class-ab/teensy-synth/schematic.pdf

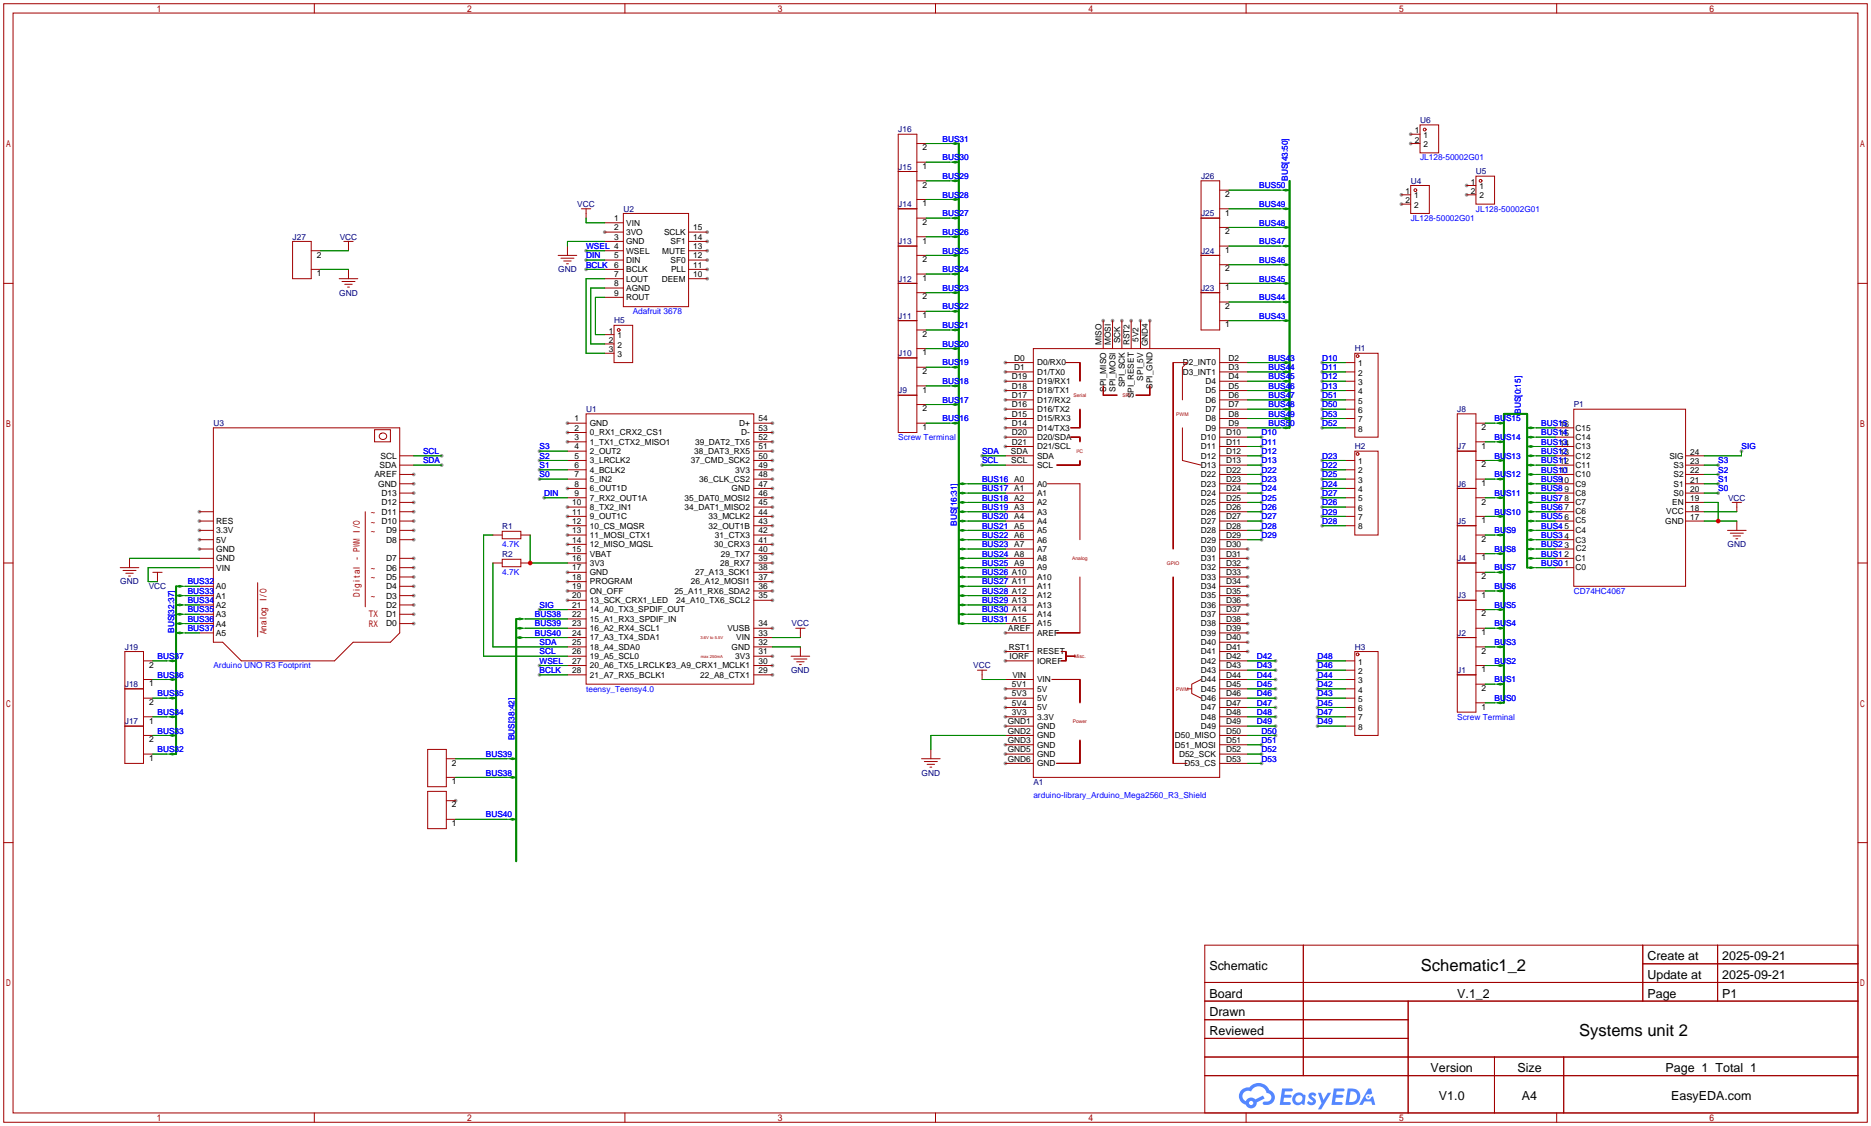
[picture p1: page 1]

DEEM 10 PLL 11 SF0 12 MUTE 13 SF1 14 SCLK 15

Schematic | Schematic1_2 | Create at | 2025-09-21

Update at | 2025-09-21

Board | V.1_2 | Page | P1
Drawn | | Systems unit 2
Reviewed

Version | Size | Page 1 Total 1
V1.0 | A4 | EasyEDA.com
