class-ab/teensy-synth/src/teensy/main.cpp

#include <Arduino.h>
#include <Wire.h>
#include <Audio.h>
// =====================================================
// Teensy 3-VCO Synth + MUX + I2C System (MASTER)
// 6 voices × 3 VCOs = 18 waveform generators
// Per-voice VCF and VCA
// =====================================================
#define MEGA_ADDRESS 0x08
#define UNO_ADDRESS 0x09
const uint8_t I2C_PACKETS_PER_FRAME = 4;
const uint8_t I2C_PACKET_SIZE = 3;
const uint8_t I2C_FRAME_SIZE = I2C_PACKETS_PER_FRAME * I2C_PACKET_SIZE;

// =====================================================
// POTENTIOMETER SCALING CONFIGURATION
// =====================================================
// Define which inputs use LINEAR or LOGARITHMIC scaling
// LINEAR: Direct value mapping (default)
// LOGARITHMIC: Exponential curve for more natural control
// 
// Usage: Set to true for LOGARITHMIC, false for LINEAR
// =====================================================

struct PotScaling {
  const char* name;
  bool isLogarithmic;
};

// MUX Pot Scaling (MUX_0 through MUX_9)
// MUX Pot Scaling (MUX_0 through MUX_9)
PotScaling muxPotScaling[10] = {
  {"MUX_0", false},   // VCO1 Detune - LINEAR
  {"MUX_1", false},   // VCO2 Detune - LINEAR
  {"MUX_2", false},   // VCO3 Detune - LINEAR
  {"MUX_3", true},    // Master Volume - LOGARITHMIC
  {"MUX_4", false},   // VCO2 Volume - LINEAR
  {"MUX_5", false},   // VCO3 Volume - LINEAR
  {"MUX_6", false},    // VCF Cutoff - LINEAR
  {"MUX_7", true},   // VCF Attack - LOGARITHMIC
  {"MUX_8", true},   // VCF Sustain - LOGARITHMIC
  {"MUX_9", true}    // VCF Resonance - LOGARITHMIC
};

// MEGA Pot Scaling (MEGA_0 through MEGA_15)
PotScaling megaPotScaling[16] = {
  {"MEGA_0", true},   // VCF Decay - LOGARITHMIC
  {"MEGA_1", false},  // VCF Env Amount - LINEAR
  {"MEGA_2", false},  // LFO 1 Speed - LINEAR
  {"MEGA_3", false},  // LFO 2 Speed - LINEAR
  {"MEGA_4", true},   // VCA Attack - LOGARITHMIC
  {"MEGA_5", true},   // VCA Decay - LOGARITHMIC
  {"MEGA_6", false},  // LFO 1 Volume - LINEAR
  {"MEGA_7", false},  // LFO 2 Volume - LINEAR
  {"MEGA_8", true},   // VCA Sustain - LOGARITHMIC
  {"MEGA_9", false},  // LFO 1 Waveform - LINEAR
  {"MEGA_10", false}, // LFO 2 Waveform - LINEAR
  {"MEGA_11", true},  // VCA Release - LOGARITHMIC
  {"MEGA_12", false},  // Reverb Time - LINEAR
  {"MEGA_13", false},  // Reverb Mix - LINEAR
  {"MEGA_14", false},  // Glissando - LINEAR
  {"MEGA_15", false}   // (unused)
};

PotScaling unoPotScaling[4] = {
  {"UNO_0", false},
  {"UNO_1", false},
  {"UNO_2", false},
  {"UNO_3", false}
};

// =====================================================
// SCALING FUNCTIONS
// =====================================================
// Convert raw pot value (0-1023) based on scaling type
int applyPotScaling(int rawValue, bool isLogarithmic) {
  if (!isLogarithmic) {
    return rawValue;  // Linear - return as-is
  }
  
  // Logarithmic scaling using exponential curve
  // This creates a more natural feel for controls like filter cutoff
  float normalized = rawValue / 1023.0;
  float scaled = (exp(normalized * 4.6052) - 1.0) / 99.0;  // exp(4.6052) ≈ 100
  return (int)(scaled * 1023.0);
}

// Reverse function - convert from logarithmic to linear if needed
int reversePotScaling(int scaledValue, bool isLogarithmic) {
  if (!isLogarithmic) {
    return scaledValue;  // Linear - return as-is
  }
  
  // Reverse the logarithmic scaling
  float scaled = scaledValue / 1023.0;
  float normalized = log(scaled * 99.0 + 1.0) / 4.6052;
  return (int)(normalized * 1023.0);
}

// =====================================================
// VCO CONTROL MAPPING - EDIT HERE
// =====================================================
// VCO 1 Controls
#define VCO1_WAVEFORM "MUX_10"
#define VCO1_DETUNE   "MUX_0"
#define VCO1_OCTAVE   "MUX_13"
// VCO 2 Controls
#define VCO2_WAVEFORM "MUX_11"
#define VCO2_VOLUME   "MUX_4"
#define VCO2_DETUNE   "MUX_1"
#define VCO2_OCTAVE   "MUX_14"
// VCO 3 Controls
#define VCO3_WAVEFORM "MUX_12"
#define VCO3_VOLUME   "MUX_5"
#define VCO3_DETUNE   "MUX_2"
#define VCO3_OCTAVE   "MUX_15"
// Master Volume Control
#define MASTER_VOLUME "MUX_3"
// VCF (Filter) Controls
#define VCF_CUTOFF     "MUX_6"
#define VCF_RESONANCE  "MUX_9"
#define VCF_ENV_AMOUNT "MEGA_1"
#define VCF_ATTACK     "MUX_7"
#define VCF_DECAY      "MEGA_0"
#define VCF_SUSTAIN    "MUX_8"
// VCA (Amplifier) Controls
#define VCA_ATTACK     "MEGA_4"
#define VCA_DECAY      "MEGA_5"
#define VCA_SUSTAIN    "MEGA_8"
#define VCA_RELEASE    "MEGA_11"
// Reverb Controls
#define REVERB_TIME     "MEGA_12"
#define REVERB_MIX      "MEGA_13"
#define GLISSANDO       "MEGA_14"
// LFO 1 Controls
#define LFO1_VOLUME   "MEGA_6"
#define LFO1_LOCATION "UNO_LOCATION_0"
#define LFO1_PITCH    "MEGA_2"
#define LFO1_WAVEFORM "MEGA_9"
// LFO 2 Controls
#define LFO2_VOLUME   "MEGA_7"
#define LFO2_LOCATION "UNO_LOCATION_1"
#define LFO2_PITCH    "MEGA_3"
#define LFO2_WAVEFORM "MEGA_10"

enum LFO1Location {
  LFO1_VCO_PITCH = 1,
  LFO1_VCF_CUTOFF,
  LFO1_VCA_VOLUME,
  LFO1_OFF
};

enum LFO2Location {
  LFO2_LFO1_SPEED = 1,
  LFO2_LFO1_VOLUME,
  LFO2_VCF_RESONANCE,
  LFO2_OFF
};

// =====================================================
// MUX Configuration
// =====================================================
const int S0 = 5, S1 = 4, S2 = 3, S3 = 2, SIG_PIN = 14;
const int firstSwitchChannel = 10;
const int numSwitches = 6;
const int totalPositions = 4;
const int switchTolerance = 5;
const int ignoreThreshold = 5;
const int firstPotChannel = 0;
const int numPots = 10;
const int potTolerance = 2;
const int detuneAmt = 1;

int currentPos[numSwitches] = {0};
int lastPotValues[numPots] = {0};

int positions[numSwitches][totalPositions] = {
  {613, 662, 746, 808},
  {411, 464, 558, 643},
  {506, 564, 659, 732},
  {516, 566, 660, 733},
  {462, 513, 610, 690},
  {646, 697, 776, 834}
};

// Enter the measured Uno A0/A1 switch readings here; -1 disables a position.
int unoLocationPositions[2][4] = {
  {804, 867, 965, 1023}, // A0: VCO pitch, VCF cutoff, VCA volume, off
  {804, 867, 965, 1023}  // A1: LFO 1 speed, LFO 1 volume, VCF resonance, off
};
const int unoLocationTolerance = 5;
int unoLocationCurrentPos[2] = {LFO1_OFF, LFO2_OFF};
int unoLocationRawValues[2] = {0, 0};

// Storage for MEGA pot values
int megaPotValues[16] = {0};
int unoPotValues[4] = {0};

// =====================================================
// Audio System
// =====================================================
AudioSynthWaveform waveform[18];
AudioMixer4 vcoMixer[6];
AudioFilterStateVariable filter[6];
AudioEffectEnvelope ampEnv[6];
AudioMixer4 voiceMixer1, voiceMixer2;
AudioMixer4 preEffectsMix;
AudioEffectReverb reverb1;
AudioMixer4 reverbMixer;
AudioMixer4 finalMix;
AudioOutputI2S i2s1;
const float VOICE_MIX_BASE_GAIN = 0.25f;

// Audio connections (same as original)
AudioConnection patchCord1(waveform[0], 0, vcoMixer[0], 0);
AudioConnection patchCord2(waveform[1], 0, vcoMixer[0], 1);
AudioConnection patchCord3(waveform[2], 0, vcoMixer[0], 2);
AudioConnection patchCord4(waveform[3], 0, vcoMixer[1], 0);
AudioConnection patchCord5(waveform[4], 0, vcoMixer[1], 1);
AudioConnection patchCord6(waveform[5], 0, vcoMixer[1], 2);
AudioConnection patchCord7(waveform[6], 0, vcoMixer[2], 0);
AudioConnection patchCord8(waveform[7], 0, vcoMixer[2], 1);
AudioConnection patchCord9(waveform[8], 0, vcoMixer[2], 2);
AudioConnection patchCord10(waveform[9], 0, vcoMixer[3], 0);
AudioConnection patchCord11(waveform[10], 0, vcoMixer[3], 1);
AudioConnection patchCord12(waveform[11], 0, vcoMixer[3], 2);
AudioConnection patchCord13(waveform[12], 0, vcoMixer[4], 0);
AudioConnection patchCord14(waveform[13], 0, vcoMixer[4], 1);
AudioConnection patchCord15(waveform[14], 0, vcoMixer[4], 2);
AudioConnection patchCord16(waveform[15], 0, vcoMixer[5], 0);
AudioConnection patchCord17(waveform[16], 0, vcoMixer[5], 1);
AudioConnection patchCord18(waveform[17], 0, vcoMixer[5], 2);
AudioConnection patchCord19(vcoMixer[0], 0, filter[0], 0);
AudioConnection patchCord20(vcoMixer[1], 0, filter[1], 0);
AudioConnection patchCord21(vcoMixer[2], 0, filter[2], 0);
AudioConnection patchCord22(vcoMixer[3], 0, filter[3], 0);
AudioConnection patchCord23(vcoMixer[4], 0, filter[4], 0);
AudioConnection patchCord24(vcoMixer[5], 0, filter[5], 0);
AudioConnection patchCord31(filter[0], 0, ampEnv[0], 0);
AudioConnection patchCord32(filter[1], 0, ampEnv[1], 0);
AudioConnection patchCord33(filter[2], 0, ampEnv[2], 0);
AudioConnection patchCord34(filter[3], 0, ampEnv[3], 0);
AudioConnection patchCord35(filter[4], 0, ampEnv[4], 0);
AudioConnection patchCord36(filter[5], 0, ampEnv[5], 0);
AudioConnection patchCord37(ampEnv[0], 0, voiceMixer1, 0);
AudioConnection patchCord38(ampEnv[1], 0, voiceMixer1, 1);
AudioConnection patchCord39(ampEnv[2], 0, voiceMixer1, 2);
AudioConnection patchCord40(ampEnv[3], 0, voiceMixer1, 3);
AudioConnection patchCord41(ampEnv[4], 0, voiceMixer2, 0);
AudioConnection patchCord42(ampEnv[5], 0, voiceMixer2, 1);
AudioConnection patchCord43(voiceMixer1, 0, preEffectsMix, 0);
AudioConnection patchCord44(voiceMixer2, 0, preEffectsMix, 1);
AudioConnection patchCord48(preEffectsMix, 0, reverb1, 0);
AudioConnection patchCord49(preEffectsMix, 0, reverbMixer, 0);
AudioConnection patchCord50(reverb1, 0, reverbMixer, 1);
AudioConnection patchCord51(reverbMixer, 0, finalMix, 0);
AudioConnection patchCord52(reverbMixer, 0, finalMix, 1);
AudioConnection patchCord53(finalMix, 0, i2s1, 0);

// =====================================================
// VCO State Variables
// =====================================================
struct VCOSettings {
  int waveform;
  float volume;
  float detune;
  int octave;
};

VCOSettings vco[3] = {
  {WAVEFORM_SINE, 1.0, 0.0, 3},    // VCO1 - volume always 1.0 (controlled by master)
  {WAVEFORM_SINE, 0.33, 0.0, 3},   // VCO2
  {WAVEFORM_SINE, 0.33, 0.0, 3}    // VCO3
};

float masterVolume = 0.5;  // Master volume control

struct FilterSettings {
  float cutoff;
  float resonance;
  float envAmount;
  float attack;
  float decay;
  float sustain;
};

FilterSettings vcfSettings = {1000.0, 0.7, 0.0, 10.0, 100.0, 0.5};

struct FilterEnvState {
  bool active;
  unsigned long noteOnTime;
};

FilterEnvState filterEnvState[6];

struct AmplifierSettings {
  float attack;
  float decay;
  float sustain;
  float release;
};

AmplifierSettings vcaSettings = {10.0, 100.0, 0.8, 200.0};

struct ReverbSettings {
  float time;
  float mix;
};

ReverbSettings reverbSettings = {2.55, 0.3};

float activeFreq[6] = {0.0};
float currentFreq[6] = {0.0};
float glideStartFreq[6] = {0.0};
unsigned long glideStartTimeMicros[6] = {0};
unsigned long glideDurationMicros[6] = {0};
float lastPlayedFrequency = 0.0f;
float lfo1Phase = 0.0f;
float lfo2Phase = 0.0f;
float lfo1Output = 0.0f;
float lfo2Output = 0.0f;
float lfo1PitchOffsetSemitones = 0.0f;
float lfo1VcaGainMultiplier = 1.0f;
float lastAppliedFilterResonance = -1.0f;

// =====================================================
// Timing
// =====================================================
unsigned long lastMuxTime = 0;
const unsigned long MUX_INTERVAL = 50;
unsigned long lastFilterUpdateMicros = 0;
const unsigned long FILTER_UPDATE_INTERVAL_MICROS = 250;
unsigned long lastI2CPoll = 0;
const unsigned long I2C_POLL_INTERVAL = 5;
unsigned long lastLfoUpdateMicros = 0;
unsigned long lastGlissandoUpdateMicros = 0;
const float LFO_MIN_SPEED_HZ = 0.2f;
const float LFO_MAX_SPEED_HZ = 400.0f;
const float GLISSANDO_MAX_TIME_SECONDS = 2.0f;
const unsigned long GLISSANDO_UPDATE_INTERVAL_MICROS = 1000;
const float LFO1_PITCH_RANGE_SEMITONES = 5.0f;
const float LFO1_CUTOFF_RANGE_OCTAVES = 4.0f;
const float LFO2_SPEED_RANGE_OCTAVES = 2.0f;
const float LFO2_RESONANCE_RANGE = 4.3f;

void pollControllers();
void pollController(uint8_t address);
void updateFilterEnvelopes();
void updateLFOs();
void readMuxSwitch(int channel, int switchIndex);
void readMuxPot(int channel, int potIndex);
void readUnoLocationSwitch(uint8_t switchIndex, int rawValue);
void updateVCOParameters();
void updateVCFParameters();
void updateVCAParameters();
void updateReverbParameters();
void updateMasterVolume();
int getControlValue(const char* control, bool isSwitch);
int mapWaveform(int position);
int mapPotToFourPosition(int value);
float calculateLfoWaveform(float phase, int position);
float calculateVcoFrequency(int voice, int vcoIndex);
void updateGlissando();
void updateActiveVoiceFrequencies();
void updateActiveVoices();
void handleNoteEvent(byte cmd, byte note);

// =====================================================
// Setup
// =====================================================
void setup() {
  Serial.begin(115200);
  delay(500);
  Serial.println("Teensy 3-VCO Synth (I2C MASTER) - ±5 Semitone Detune + Master Volume");

  pinMode(S0, OUTPUT);
  pinMode(S1, OUTPUT);
  pinMode(S2, OUTPUT);
  pinMode(S3, OUTPUT);

  AudioMemory(180);

  // Initialize waveforms
  for (int i = 0; i < 18; i++) {
    waveform[i].begin(WAVEFORM_SINE);
    waveform[i].amplitude(1.0);
  }

  // Initialize mixers with VCO volumes
  for (int i = 0; i < 6; i++) {
    vcoMixer[i].gain(0, vco[0].volume);
    vcoMixer[i].gain(1, vco[1].volume);
    vcoMixer[i].gain(2, vco[2].volume);
    vcoMixer[i].gain(3, 0.0);
  }

  // Initialize filters and envelopes
  for (int i = 0; i < 6; i++) {
    filter[i].frequency(vcfSettings.cutoff);
    filter[i].resonance(vcfSettings.resonance);
    
    filterEnvState[i].active = false;
    
    ampEnv[i].attack(vcaSettings.attack);
    ampEnv[i].decay(vcaSettings.decay);
    ampEnv[i].sustain(vcaSettings.sustain);
    ampEnv[i].release(vcaSettings.release);
  }

  for (int i = 0; i < 4; i++) {
    voiceMixer1.gain(i, VOICE_MIX_BASE_GAIN);
    voiceMixer2.gain(i, VOICE_MIX_BASE_GAIN);
  }

  preEffectsMix.gain(0, 0.5);
  preEffectsMix.gain(1, 0.5);

  reverb1.reverbTime(reverbSettings.time);
  reverbMixer.gain(0, 1.0 - reverbSettings.mix);
  reverbMixer.gain(1, reverbSettings.mix);

  // Apply master volume to final mix
  finalMix.gain(0, masterVolume);
  finalMix.gain(1, masterVolume);

  // Initialize as I2C master only
  Wire.begin();  // Master mode
  Wire.setClock(100000);

  delay(1000);
  Serial.println("I2C master ready - polling MEGA and UNO");
  
  // Print pot scaling configuration
  Serial.println("\n=== Pot Scaling Configuration ===");
  Serial.println("MUX Pots:");
  for (int i = 0; i < numPots; i++) {
    Serial.printf("  %s: %s\n", muxPotScaling[i].name, 
                  muxPotScaling[i].isLogarithmic ? "LOGARITHMIC" : "LINEAR");
  }
  Serial.println("MEGA Pots:");
  for (int i = 0; i < 16; i++) {
    Serial.printf("  %s: %s\n", megaPotScaling[i].name, 
                  megaPotScaling[i].isLogarithmic ? "LOGARITHMIC" : "LINEAR");
  }
  Serial.println("UNO Pots:");
  for (int i = 0; i < 4; i++) {
    Serial.printf("  %s: %s\n", unoPotScaling[i].name,
                  unoPotScaling[i].isLogarithmic ? "LOGARITHMIC" : "LINEAR");
  }
  Serial.println("=================================");
  Serial.println("VCO Detune Range: ±5 semitones");
  Serial.println("Master Volume: Controlled by MUX_3");
  Serial.println("=================================\n");
  
  // Initial control read
  for (int i = 0; i < numSwitches; i++) {
    readMuxSwitch(firstSwitchChannel + i, i);
  }
  for (int i = 0; i < numPots; i++) {
    readMuxPot(firstPotChannel + i, i);
  }

  updateVCOParameters();
  updateVCFParameters();
  updateVCAParameters();
  updateReverbParameters();
  updateMasterVolume();

  lastLfoUpdateMicros = micros();
  Serial.println("Synth ready");
}

// =====================================================
// Main Loop
// =====================================================
void loop() {
  unsigned long now = millis();

  // Poll both I2C controller slaves for queued packets.
  if (now - lastI2CPoll >= I2C_POLL_INTERVAL) {
    lastI2CPoll = now;
    pollControllers();
  }

  updateLFOs();
  updateGlissando();

  // Update filter envelopes and cutoff modulation at 4 kHz.
  unsigned long filterNowMicros = micros();
  if (filterNowMicros - lastFilterUpdateMicros >=
      FILTER_UPDATE_INTERVAL_MICROS) {
    lastFilterUpdateMicros = filterNowMicros;
    updateFilterEnvelopes();
  }

  // Read local MUX controls
  if (now - lastMuxTime >= MUX_INTERVAL) {
    lastMuxTime = now;
    
    for (int i = 0; i < numSwitches; i++) {
      readMuxSwitch(firstSwitchChannel + i, i);
    }
    for (int i = 0; i < numPots; i++) {
      readMuxPot(firstPotChannel + i, i);
    }
    
    updateVCOParameters();
    updateVCFParameters();
    updateVCAParameters();
    updateReverbParameters();
    updateMasterVolume();
  }
}

// =====================================================
// I2C Polling - Request queued data from both controllers
// =====================================================
void pollControllers() {
  pollController(MEGA_ADDRESS);
  pollController(UNO_ADDRESS);
}

void pollController(uint8_t address) {
  int bytesReceived = Wire.requestFrom(address, I2C_FRAME_SIZE);
  
  while (bytesReceived >= I2C_PACKET_SIZE && Wire.available() >= I2C_PACKET_SIZE) {
    byte b0 = Wire.read();
    byte b1 = Wire.read();
    byte b2 = Wire.read();
    bytesReceived -= I2C_PACKET_SIZE;
    
    if (b0 == 255) {
      continue;
    }

    if (address == MEGA_ADDRESS) {
      if (b0 <= 1) {
        handleNoteEvent(b0, b1);
      } else if (b0 >= 100 && b0 < 116) {
        int megaIndex = b0 - 100;
        int value = 1023 - ((b1 << 8) | b2);
        megaPotValues[megaIndex] = applyPotScaling(
          value, megaPotScaling[megaIndex].isLogarithmic);
      }
    } else if (address == UNO_ADDRESS) {
      int value = (b1 << 8) | b2;
      if (b0 < 2) {
        Serial.printf("[UNO I2C] A%u = %d\n", (unsigned int)b0, value);
      }
      if (b0 < 2) {
        unoLocationRawValues[b0] = value;
        readUnoLocationSwitch(b0, value);
      } else if (b0 < 4) {
        unoPotValues[b0] = applyPotScaling(
          value, unoPotScaling[b0].isLogarithmic);
      }
    }
  }

  while (Wire.available()) {
    Wire.read();
  }
}

// =====================================================
// MUX Helpers
// =====================================================
void setMuxChannel(int ch) {
  digitalWrite(S0, bitRead(ch, 0));
  digitalWrite(S1, bitRead(ch, 1));
  digitalWrite(S2, bitRead(ch, 2));
  digitalWrite(S3, bitRead(ch, 3));
  delayMicroseconds(5);
}

void readMuxSwitch(int channel, int switchIndex) {
  setMuxChannel(channel);
  int val = analogRead(SIG_PIN);
  if (val <= ignoreThreshold) return;
  
  for (int p = 0; p < totalPositions; p++) {
    int target = positions[switchIndex][p];
    if (val >= target - switchTolerance && val <= target + switchTolerance) {
      if (currentPos[switchIndex] != p + 1) {
        currentPos[switchIndex] = p + 1;
        Serial.printf("[MUX] Switch %d → pos %d (raw %d)\n",
                      switchIndex + 1, currentPos[switchIndex], val);
      }
      return;
    }
  }
}

void readUnoLocationSwitch(uint8_t switchIndex, int rawValue) {
  for (int position = 0; position < 4; position++) {
    int target = unoLocationPositions[switchIndex][position];
    if (target >= 0 && rawValue >= target - unoLocationTolerance &&
        rawValue <= target + unoLocationTolerance) {
      int newPosition = position + 1;
      if (unoLocationCurrentPos[switchIndex] != newPosition) {
        unoLocationCurrentPos[switchIndex] = newPosition;
      }
      return;
    }
  }
}

void readMuxPot(int channel, int potIndex) {
  setMuxChannel(channel);
  int val = analogRead(SIG_PIN);
  val = 1023 - val;
  
  // Apply scaling based on configuration
  val = applyPotScaling(val, muxPotScaling[potIndex].isLogarithmic);
  
  if (abs(val - lastPotValues[potIndex]) > potTolerance) {
    lastPotValues[potIndex] = val;
  }
}

// =====================================================
// Filter Envelope Calculation
// =====================================================
float calculateFilterEnvelope(int voice, unsigned long now) {
  if (!filterEnvState[voice].active) return 0.0;

  unsigned long elapsed = now - filterEnvState[voice].noteOnTime;
  
  if (elapsed < vcfSettings.attack) {
    return (float)elapsed / vcfSettings.attack;
  } else if (elapsed < vcfSettings.attack + vcfSettings.decay) {
    unsigned long decayElapsed = elapsed - vcfSettings.attack;
    float decayProgress = (float)decayElapsed / vcfSettings.decay;
    return 1.0 - (decayProgress * (1.0 - vcfSettings.sustain));
  } else {
    return vcfSettings.sustain;
  }
}

void updateFilterEnvelopes() {
  unsigned long now = millis();
  float lfoCutoffOctaves =
    getControlValue(LFO1_LOCATION, true) == LFO1_VCF_CUTOFF
      ? lfo1Output * LFO1_CUTOFF_RANGE_OCTAVES
      : 0.0f;
  
  for (int v = 0; v < 6; v++) {
    float envValue = calculateFilterEnvelope(v, now);
    float octaveShift =
      envValue * vcfSettings.envAmount * 4.0f + lfoCutoffOctaves;
    float modulatedCutoff = vcfSettings.cutoff * powf(2.0f, octaveShift);
    modulatedCutoff = constrain(modulatedCutoff, 20.0f, 12000.0f);
    filter[v].frequency(modulatedCutoff);
  }
}

// =====================================================
// Parameter Updates
// =====================================================
void updateVCOParameters() {
  bool changed = false;
  
  // VCO 1 - No volume control (uses master volume)
  int vco1Wave = getControlValue(VCO1_WAVEFORM, true);
  int vco1Det = getControlValue(VCO1_DETUNE, false);
  int vco1Oct = getControlValue(VCO1_OCTAVE, true);
  
  int newWave1 = mapWaveform(vco1Wave);
  if (newWave1 != vco[0].waveform) {
    vco[0].waveform = newWave1;
    changed = true;
  }
  
  // Detune range: ±5 semitones (was ±1)
  float newDet1 = ((vco1Det - 512) / 512.0) * detuneAmt;  // Range: -5 to +5 semitones
  if (abs(newDet1 - vco[0].detune) > 0.01) {
    vco[0].detune = newDet1;
    changed = true;
  }
  
  if (vco1Oct != vco[0].octave && vco1Oct >= 1 && vco1Oct <= 4) {
    vco[0].octave = vco1Oct;
    changed = true;
  }
  
  // VCO 2
  int vco2Wave = getControlValue(VCO2_WAVEFORM, true);
  int vco2Vol = getControlValue(VCO2_VOLUME, false);
  int vco2Det = getControlValue(VCO2_DETUNE, false);
  int vco2Oct = getControlValue(VCO2_OCTAVE, true);
  
  int newWave2 = mapWaveform(vco2Wave);
  if (newWave2 != vco[1].waveform) {
    vco[1].waveform = newWave2;
    changed = true;
  }
  
  float newVol2 = vco2Vol / 1023.0;
  if (abs(newVol2 - vco[1].volume) > 0.01) {
    vco[1].volume = newVol2;
    for (int v = 0; v < 6; v++) {
      vcoMixer[v].gain(1, newVol2);
    }
    changed = true;
  }
  
  // Detune range: ±5 semitones (was ±1)
  float newDet2 = ((vco2Det - 512) / 512.0) * detuneAmt;  // Range: -5 to +5 semitones
  if (abs(newDet2 - vco[1].detune) > 0.01) {
    vco[1].detune = newDet2;
    changed = true;
  }
  
  if (vco2Oct != vco[1].octave && vco2Oct >= 1 && vco2Oct <= 4) {
    vco[1].octave = vco2Oct;
    changed = true;
  }
  
  // VCO 3
  int vco3Wave = getControlValue(VCO3_WAVEFORM, true);
  int vco3Vol = getControlValue(VCO3_VOLUME, false);
  int vco3Det = getControlValue(VCO3_DETUNE, false);
  int vco3Oct = getControlValue(VCO3_OCTAVE, true);
  
  int newWave3 = mapWaveform(vco3Wave);
  if (newWave3 != vco[2].waveform) {
    vco[2].waveform = newWave3;
    changed = true;
  }
  
  float newVol3 = vco3Vol / 1023.0;
  if (abs(newVol3 - vco[2].volume) > 0.01) {
    vco[2].volume = newVol3;
    for (int v = 0; v < 6; v++) {
      vcoMixer[v].gain(2, newVol3);
    }
    changed = true;
  }
  
  // Detune range: ±5 semitones (was ±1)
  float newDet3 = ((vco3Det - 512) / 512.0) * detuneAmt;  // Range: -5 to +5 semitones
  if (abs(newDet3 - vco[2].detune) > 0.01) {
    vco[2].detune = newDet3;
    changed = true;
  }
  
  if (vco3Oct != vco[2].octave && vco3Oct >= 1 && vco3Oct <= 4) {
    vco[2].octave = vco3Oct;
    changed = true;
  }
  
  if (changed) {
    updateActiveVoices();
  }
}

void updateMasterVolume() {
  int masterVal = getControlValue(MASTER_VOLUME, false);
  float newMaster = masterVal / 1023.0;
  
  if (abs(newMaster - masterVolume) > 0.01) {
    masterVolume = newMaster;
    finalMix.gain(0, masterVolume);
    finalMix.gain(1, masterVolume);
    Serial.printf("[MASTER] Volume: %.2f\n", masterVolume);
  }
}

void updateVCFParameters() {
  bool changed = false;
  
  int cutoffVal = getControlValue(VCF_CUTOFF, false);
  float newCutoff = 20.0 * powf(500.0, cutoffVal / 1023.0);
  if (abs(newCutoff - vcfSettings.cutoff) > 10.0) {
    vcfSettings.cutoff = newCutoff;
    changed = true;
  }
  
  int resVal = getControlValue(VCF_RESONANCE, false);
  float newRes = 0.7 + (resVal / 1023.0) * 4.3;
  if (abs(newRes - vcfSettings.resonance) > 0.05) {
    vcfSettings.resonance = newRes;
    lastAppliedFilterResonance = -1.0f;
    changed = true;
  }
  
  int envAmtVal = getControlValue(VCF_ENV_AMOUNT, false);
  float newEnvAmt = envAmtVal / 1023.0;
  if (abs(newEnvAmt - vcfSettings.envAmount) > 0.01) {
    vcfSettings.envAmount = newEnvAmt;
    changed = true;
  }
  
  int attackVal = getControlValue(VCF_ATTACK, false);
  float newAttack = (attackVal / 1023.0) * 2000.0;
  if (abs(newAttack - vcfSettings.attack) > 5.0) {
    vcfSettings.attack = newAttack;
    changed = true;
  }
  
  int decayVal = getControlValue(VCF_DECAY, false);
  float newDecay = (decayVal / 1023.0) * 2000.0;
  if (abs(newDecay - vcfSettings.decay) > 5.0) {
    vcfSettings.decay = newDecay;
    changed = true;
  }
  
  int sustainVal = getControlValue(VCF_SUSTAIN, false);
  float newSustain = sustainVal / 1023.0;
  if (abs(newSustain - vcfSettings.sustain) > 0.01) {
    vcfSettings.sustain = newSustain;
    changed = true;
  }
}

void updateVCAParameters() {
  bool changed = false;
  
  int attackVal = getControlValue(VCA_ATTACK, false);
  float newAttack = (attackVal / 1023.0) * 2000.0;
  if (abs(newAttack - vcaSettings.attack) > 5.0) {
    vcaSettings.attack = newAttack;
    for (int i = 0; i < 6; i++) {
      ampEnv[i].attack(newAttack);
    }
    changed = true;
  }
  
  int decayVal = getControlValue(VCA_DECAY, false);
  float newDecay = (decayVal / 1023.0) * 2000.0;
  if (abs(newDecay - vcaSettings.decay) > 5.0) {
    vcaSettings.decay = newDecay;
    for (int i = 0; i < 6; i++) {
      ampEnv[i].decay(newDecay);
    }
    changed = true;
  }
  
  int sustainVal = getControlValue(VCA_SUSTAIN, false);
  float newSustain = sustainVal / 1023.0;
  if (abs(newSustain - vcaSettings.sustain) > 0.01) {
    vcaSettings.sustain = newSustain;
    for (int i = 0; i < 6; i++) {
      ampEnv[i].sustain(newSustain);
    }
    changed = true;
  }
  
  int releaseVal = getControlValue(VCA_RELEASE, false);
  float newRelease = (releaseVal / 1023.0) * 3000.0;
  if (abs(newRelease - vcaSettings.release) > 5.0) {
    vcaSettings.release = newRelease;
    for (int i = 0; i < 6; i++) {
      ampEnv[i].release(newRelease);
    }
    changed = true;
  }
}

void updateReverbParameters() {
  bool changed = false;
  
  // Reverb time: 0.1 to 5.0 seconds
  int timeVal = getControlValue(REVERB_TIME, false);
  float newTime = 0.1f + (timeVal / 1023.0f) * 4.9f;
  if (abs(newTime - reverbSettings.time) > 0.05f) {
    reverbSettings.time = newTime;
    reverb1.reverbTime(newTime);
    changed = true;
  }
  
  // Reverb mix: 0.0 to 1.0
  int mixVal = getControlValue(REVERB_MIX, false);
  float newMix = mixVal / 1023.0;
  if (abs(newMix - reverbSettings.mix) > 0.01) {
    reverbSettings.mix = newMix;
    reverbMixer.gain(0, 1.0 - newMix);  // Dry
    reverbMixer.gain(1, newMix);         // Wet
    changed = true;
  }
  
  if (changed) {
    Serial.println("[REVERB] Parameters updated");
  }
}

// =====================================================
// Control Value Getter
// =====================================================
int getControlValue(const char* control, bool isSwitch) {
  if (strncmp(control, "MUX_", 4) == 0) {
    int channel = atoi(control + 4);
    if (isSwitch) {
      int switchIndex = channel - firstSwitchChannel;
      if (switchIndex >= 0 && switchIndex < numSwitches) {
        return currentPos[switchIndex];
      }
    } else {
      int potIndex = channel - firstPotChannel;
      if (potIndex >= 0 && potIndex < numPots) {
        return lastPotValues[potIndex];
      }
    }
  } else if (strncmp(control, "MEGA_", 5) == 0) {
    int index = atoi(control + 5);
    if (index >= 0 && index < 16) {
      return megaPotValues[index];
    }
  } else if (strncmp(control, "UNO_LOCATION_", 13) == 0) {
    int index = atoi(control + 13);
    if (index >= 0 && index < 2) {
      return unoLocationCurrentPos[index];
    }
  } else if (strncmp(control, "UNO_", 4) == 0) {
    int index = atoi(control + 4);
    if (index >= 0 && index < 4) {
      return unoPotValues[index];
    }
  }
  return 0;
}

// =====================================================
// Waveform Mapper
// =====================================================
int mapWaveform(int position) {
  switch (position) {
    case 1: return WAVEFORM_SINE;
    case 2: return WAVEFORM_SAWTOOTH;
    case 3: return WAVEFORM_SQUARE;
    case 4: return WAVEFORM_TRIANGLE;
    default: return WAVEFORM_SINE;
  }
}

int mapPotToFourPosition(int value) {
  int boundedValue = constrain(value, 0, 1023);
  int section = boundedValue * 4 / 1023;
  return section >= 4 ? 4 : section + 1;
}

float calculateLfoWaveform(float phase, int position) {
  switch (position) {
    case 1: return sinf(phase * 6.28318530718f);
    case 2: return 2.0f * phase - 1.0f;
    case 3: return phase < 0.5f ? 1.0f : -1.0f;
    case 4: return 1.0f - 4.0f * fabsf(phase - 0.5f);
    default: return 0.0f;
  }
}

void updateLFOs() {
  unsigned long nowMicros = micros();
  unsigned long elapsedMicros = nowMicros - lastLfoUpdateMicros;
  if (elapsedMicros == 0) {
    return;
  }
  lastLfoUpdateMicros = nowMicros;
  float elapsedSeconds = elapsedMicros / 1000000.0f;

  int lfo2SpeedValue = constrain(getControlValue(LFO2_PITCH, false), 0, 1023);
  float lfo2Frequency = LFO_MIN_SPEED_HZ +
    (LFO_MAX_SPEED_HZ - LFO_MIN_SPEED_HZ) * (lfo2SpeedValue / 1023.0f);
  float lfo2Depth = constrain(getControlValue(LFO2_VOLUME, false), 0, 1023) /
    1023.0f;
  int lfo2WavePosition =
    mapPotToFourPosition(getControlValue(LFO2_WAVEFORM, false));
  int lfo2Location = getControlValue(LFO2_LOCATION, true);

  lfo2Phase = fmodf(lfo2Phase + lfo2Frequency * elapsedSeconds, 1.0f);
  lfo2Output = calculateLfoWaveform(lfo2Phase, lfo2WavePosition) * lfo2Depth;

  int lfo1SpeedValue = constrain(getControlValue(LFO1_PITCH, false), 0, 1023);
  float lfo1Frequency = LFO_MIN_SPEED_HZ +
    (LFO_MAX_SPEED_HZ - LFO_MIN_SPEED_HZ) * (lfo1SpeedValue / 1023.0f);
  if (lfo2Location == LFO2_LFO1_SPEED) {
    lfo1Frequency *= powf(2.0f, lfo2Output * LFO2_SPEED_RANGE_OCTAVES);
  }
  lfo1Frequency = constrain(lfo1Frequency, LFO_MIN_SPEED_HZ, LFO_MAX_SPEED_HZ);

  int lfo1WavePosition =
    mapPotToFourPosition(getControlValue(LFO1_WAVEFORM, false));
  int lfo1Location = getControlValue(LFO1_LOCATION, true);
  float lfo1Depth = constrain(getControlValue(LFO1_VOLUME, false), 0, 1023) /
    1023.0f;
  if (lfo2Location == LFO2_LFO1_VOLUME) {
    lfo1Depth = constrain(lfo1Depth + lfo2Output, 0.0f, 1.0f);
  }

  lfo1Phase = fmodf(lfo1Phase + lfo1Frequency * elapsedSeconds, 1.0f);
  lfo1Output = calculateLfoWaveform(lfo1Phase, lfo1WavePosition) * lfo1Depth;

  float newPitchOffset =
    lfo1Location == LFO1_VCO_PITCH
      ? lfo1Output * LFO1_PITCH_RANGE_SEMITONES
      : 0.0f;
  if (fabsf(newPitchOffset - lfo1PitchOffsetSemitones) > 0.01f) {
    lfo1PitchOffsetSemitones = newPitchOffset;
    updateActiveVoiceFrequencies();
  }

  float newVcaGainMultiplier = lfo1Location == LFO1_VCA_VOLUME
    ? 1.0f - lfo1Depth * 0.5f + lfo1Output * 0.5f
    : 1.0f;
  if (fabsf(newVcaGainMultiplier - lfo1VcaGainMultiplier) > 0.005f) {
    lfo1VcaGainMultiplier = newVcaGainMultiplier;
    for (int voice = 0; voice < 6; voice++) {
      float gain = VOICE_MIX_BASE_GAIN * lfo1VcaGainMultiplier;
      if (voice < 4) {
        voiceMixer1.gain(voice, gain);
      } else {
        voiceMixer2.gain(voice - 4, gain);
      }
    }
  }

  float modulatedResonance = vcfSettings.resonance;
  if (lfo2Location == LFO2_VCF_RESONANCE) {
    modulatedResonance += lfo2Output * LFO2_RESONANCE_RANGE;
  }
  modulatedResonance = constrain(modulatedResonance, 0.7f, 5.0f);
  if (fabsf(modulatedResonance - lastAppliedFilterResonance) > 0.01f) {
    lastAppliedFilterResonance = modulatedResonance;
    for (int voice = 0; voice < 6; voice++) {
      filter[voice].resonance(modulatedResonance);
    }
  }
}

float calculateVcoFrequency(int voice, int vcoIndex) {
  int octaveShift = vco[vcoIndex].octave - 3;
  float octaveMultiplier = powf(2.0f, octaveShift);
  float semitoneOffset = vco[vcoIndex].detune + lfo1PitchOffsetSemitones;
  return currentFreq[voice] * octaveMultiplier *
    powf(2.0f, semitoneOffset / 12.0f);
}

void updateGlissando() {
  unsigned long nowMicros = micros();
  if (nowMicros - lastGlissandoUpdateMicros <
      GLISSANDO_UPDATE_INTERVAL_MICROS) {
    return;
  }
  lastGlissandoUpdateMicros = nowMicros;

  for (int voice = 0; voice < 6; voice++) {
    if (activeFreq[voice] <= 0.0f || glideDurationMicros[voice] == 0) {
      continue;
    }

    unsigned long elapsedMicros =
      nowMicros - glideStartTimeMicros[voice];
    if (elapsedMicros >= glideDurationMicros[voice]) {
      currentFreq[voice] = activeFreq[voice];
      glideDurationMicros[voice] = 0;
    } else {
      float progress = (float)elapsedMicros / glideDurationMicros[voice];
      currentFreq[voice] = glideStartFreq[voice] *
        powf(activeFreq[voice] / glideStartFreq[voice], progress);
    }

    for (int vcoIndex = 0; vcoIndex < 3; vcoIndex++) {
      int waveformIndex = voice * 3 + vcoIndex;
      waveform[waveformIndex].frequency(
        calculateVcoFrequency(voice, vcoIndex));
    }
  }
}

// =====================================================
// Synth Voice Handling
// =====================================================
void handleNoteEvent(byte cmd, byte note) {
  float baseFreq = 440.0 * powf(2.0, (note - 69) / 12.0);

  if (cmd == 1) {  // NoteOn
    Serial.println("NOTE RECEIVED");
    
    // First, try to find a completely free voice (not playing or releasing)
    int freeVoice = -1;
    for (int v = 0; v < 6; v++) {
      if (activeFreq[v] == 0.0 && !ampEnv[v].isActive()) {
        freeVoice = v;
        break;
      }
    }
    
    // If no completely free voice, find one that's not actively held (can be releasing)
    if (freeVoice == -1) {
      for (int v = 0; v < 6; v++) {
        if (activeFreq[v] == 0.0) {
          freeVoice = v;
          break;
        }
      }
    }
    
    // If still no free voice, steal the oldest voice
    if (freeVoice == -1) {
      freeVoice = 0;  // Simple voice stealing - take voice 0
    }
    
    if (freeVoice != -1) {
      int v = freeVoice;
      float voiceGain = VOICE_MIX_BASE_GAIN * lfo1VcaGainMultiplier;
      int glissandoValue = constrain(getControlValue(GLISSANDO, false), 0, 1023);
      unsigned long glideDuration = (unsigned long)(
        (glissandoValue / 1023.0f) * GLISSANDO_MAX_TIME_SECONDS *
        1000000.0f);
      float startingFrequency =
        glideDuration > 0 && lastPlayedFrequency > 0.0f
          ? lastPlayedFrequency
          : baseFreq;

      if (v < 4) {
        voiceMixer1.gain(v, voiceGain);
      } else {
        voiceMixer2.gain(v - 4, voiceGain);
      }
      
      activeFreq[v] = baseFreq;
      currentFreq[v] = startingFrequency;
      glideStartFreq[v] = startingFrequency;
      glideStartTimeMicros[v] = micros();
      glideDurationMicros[v] = glideDuration;
      lastPlayedFrequency = baseFreq;
      
      // Set all 3 VCOs for this voice
      for (int vco_num = 0; vco_num < 3; vco_num++) {
        int wfIndex = v * 3 + vco_num;
        waveform[wfIndex].begin(vco[vco_num].waveform);
        waveform[wfIndex].frequency(calculateVcoFrequency(v, vco_num));
        waveform[wfIndex].amplitude(1.0);  // Full amplitude, VCA controls volume
      }
      
      // Trigger filter and amplitude envelopes for this voice
      filterEnvState[v].active = true;
      filterEnvState[v].noteOnTime = millis();
      ampEnv[v].noteOn();
    }
  } else {  // NoteOff
    for (int v = 0; v < 6; v++) {
      if (fabs(activeFreq[v] - baseFreq) < 1.0) {
        activeFreq[v] = 0.0;
        
        // Stop filter modulation immediately; the VCA keeps its release phase.
        filterEnvState[v].active = false;
        ampEnv[v].noteOff();
        
        break;  // Only release one voice per note-off
      }
    }
  }
}

// =====================================================
// Update Active Voices (for detune/octave changes)
// =====================================================
void updateActiveVoices() {
  for (int v = 0; v < 6; v++) {
    if (activeFreq[v] > 0.0) {
      for (int vco_num = 0; vco_num < 3; vco_num++) {
        int wfIndex = v * 3 + vco_num;
        waveform[wfIndex].frequency(calculateVcoFrequency(v, vco_num));
        waveform[wfIndex].begin(vco[vco_num].waveform);
      }
    }
  }
}

void updateActiveVoiceFrequencies() {
  for (int voice = 0; voice < 6; voice++) {
    if (activeFreq[voice] <= 0.0f) {
      continue;
    }
    for (int vcoIndex = 0; vcoIndex < 3; vcoIndex++) {
      int waveformIndex = voice * 3 + vcoIndex;
      waveform[waveformIndex].frequency(
        calculateVcoFrequency(voice, vcoIndex));
    }
  }
}
