class-ab/teensy-synth/(commit log)

2026-05-23 schematic upload
2026-10-31 final key changes (no velocity :sad:)
2026-11-01 test uno i2c
